sarsky/Mozzie/docs/source/PreFlight.rst

Pre-Flight
===========

== ================================================================================
   **Pre Flight Checklist**
== ================================================================================
1  Check wings and quad assemblies for damage and ensure they are secured
2  Check control linkages and surfaces for defects
3  Check wiring connections and cables for defects
4  Check motor spin/dir/mounts and that props are tight with wrench
5  RC TX booted, TX Bat ok, PXH Mode ok, throttle down?
6  Check Batteries and install, COG ok, PXH green, pitot clear?
7  Airspeed, avionics, AHRS/IMU, Compass, GPS 3d lock, Bat, all ok on MP, precal?
8  Check control surfaces in Stabilise, quad motors in Qstabilise
9  Critical Parameters ok? Mission WP ok and RTL loaded?
10 Arm in stabilise/qstabilise and launch.
== ================================================================================

================== ============ ============
**Battery State**  **4S Lipo**  **4S LiHV**
================== ============ ============
100%               16.8V
80%                15.6V
60%                15.4V
50%                15.28V
40%                15V
20%                14.8V
10%                14.7V
================== ============ ============

=================== ===================== ================== =========================
**PXH LED Codes**   **Fault**             **Cause**          **Remedy**
=================== ===================== ================== =========================
Green LED	          PXH Booted - GPS Lock Ready to ARM
Blue LED	          NO GPS Lock	          Bad GPS Health     GPS Satellite' Visible?
Flashing yellow LED Failsafe triggered    Restart PXH	     Check failsafe to trigger
=================== ===================== ================== =========================

============== ===================== ========================= ==========================
**GPS LED**    **Fault**             **Cause**                 **Remedy**
============== ===================== ========================= ==========================
GPS Power      No Red LED            No Power - No Connection  Check power and wiring
GPS Signal     No Flashing Blue LED  No Lock - NO GPS Signal   GPS Satellites Visible?
============== ===================== ========================= ==========================

Flight Modes
-------------

List flight modes to be used with Mozzie

Range Check
----------------

RX range Check - chk RX setup and link - is this relevant with PPM over RFDx??

RFD900x Range Check?
