sarsky/Mozzie/docs/source/images/AE/3DPrintAs.png

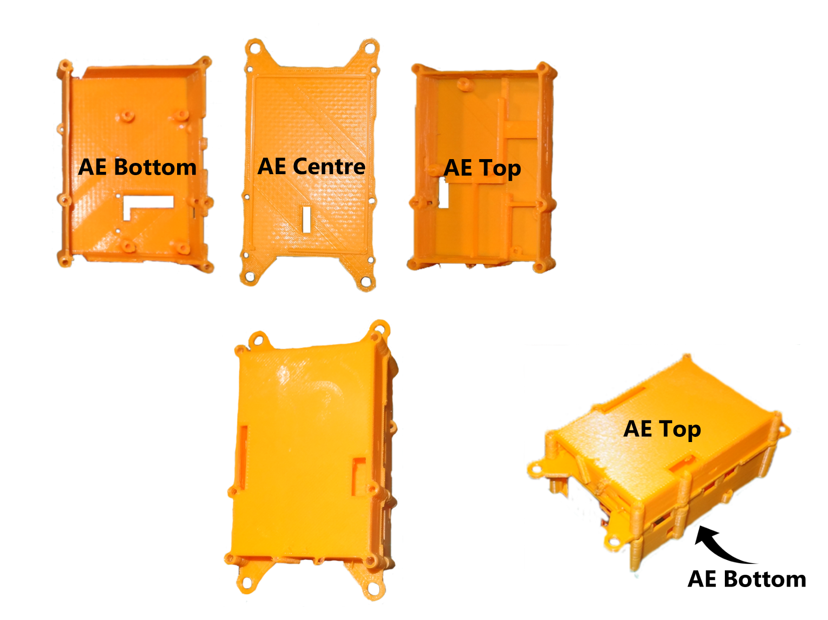
docs/source/images/AE/3DPrintAs.png
