sarsky/Mozzie/docs/source/images/AE/AEPixhawk.jpg

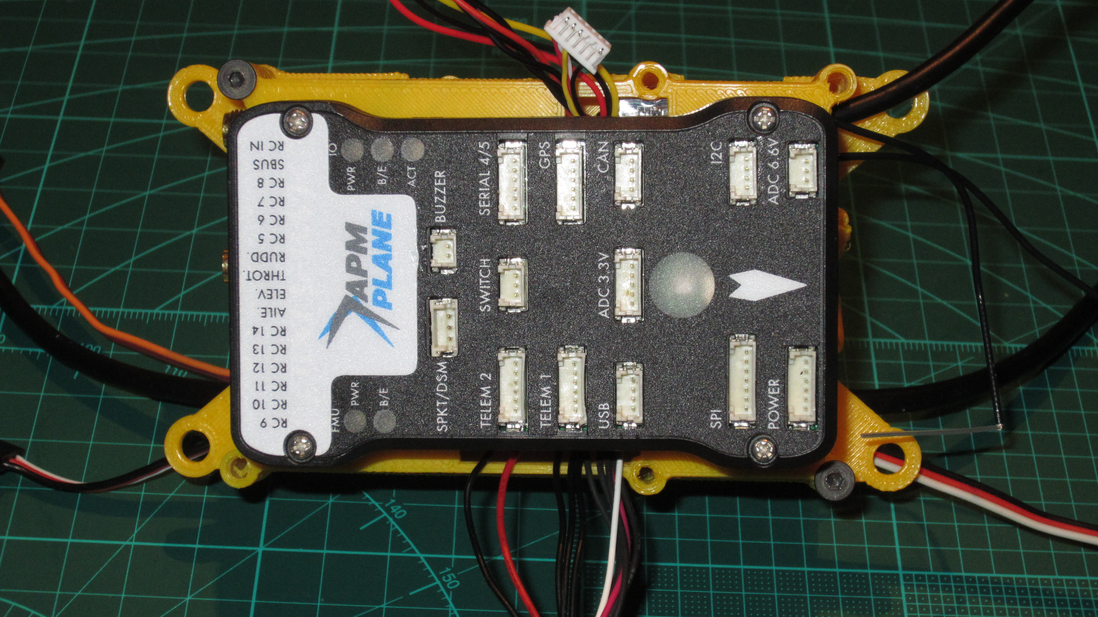
docs/source/images/AE/AEPixhawk.jpg
