sarsky/Mozzie/docs/source/images/AE/AEPixhawkCables2.jpg

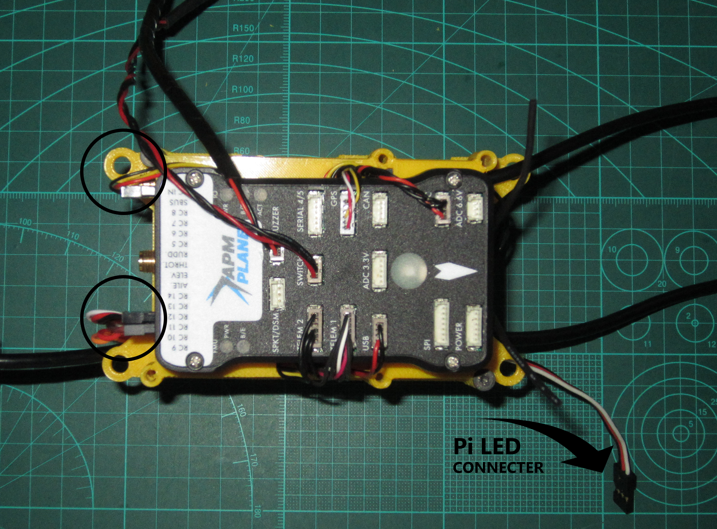
docs/source/images/AE/AEPixhawkCables2.jpg
