sarsky/Mozzie/docs/source/images/AE/AEPixhawkCables.jpg

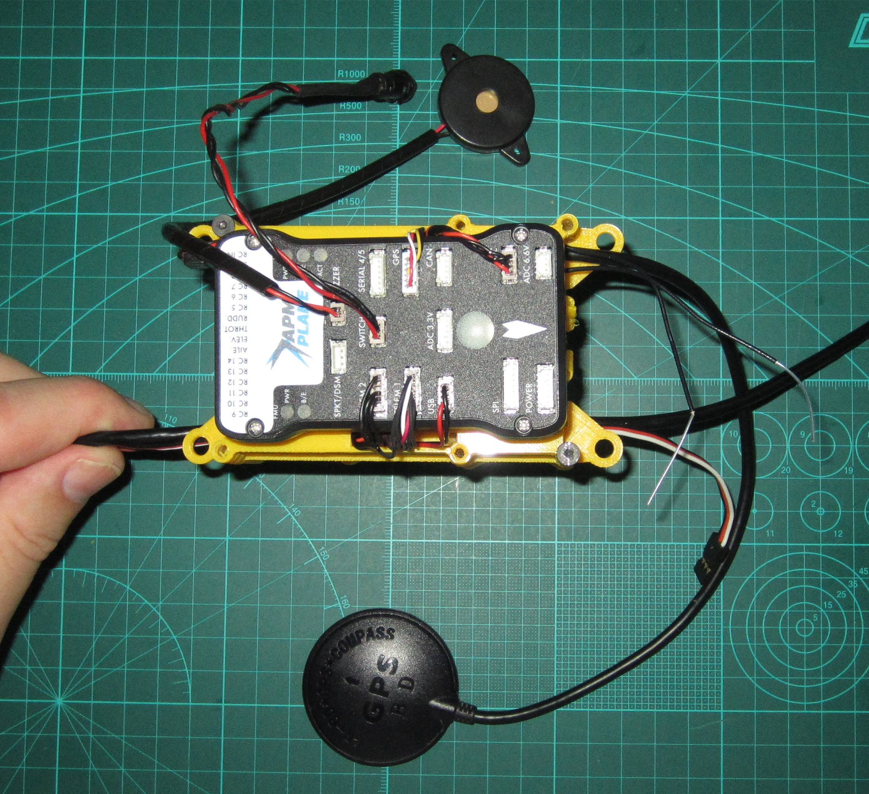
docs/source/images/AE/AEPixhawkCables.jpg
