sarsky/Mozzie/docs/source/images/AE/AirAECompGPS.jpg

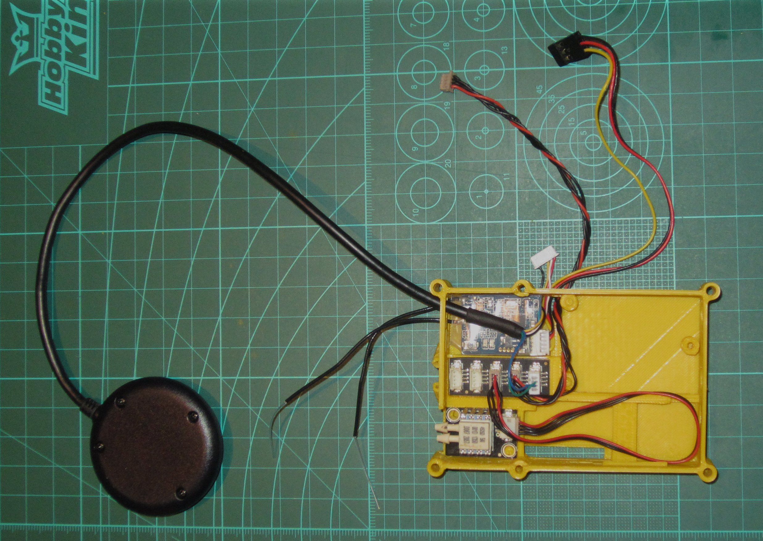
docs/source/images/AE/AirAECompGPS.jpg
