sarsky/Mozzie/docs/source/images/AE/AirAECompRFD.jpg

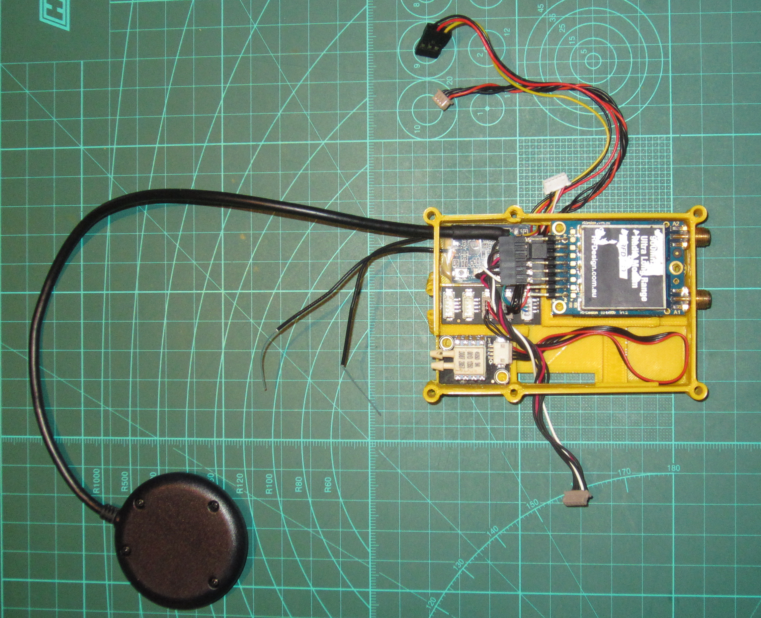
docs/source/images/AE/AirAECompRFD.jpg
