sarsky/Mozzie/docs/source/images/AE/FuseCut.jpg

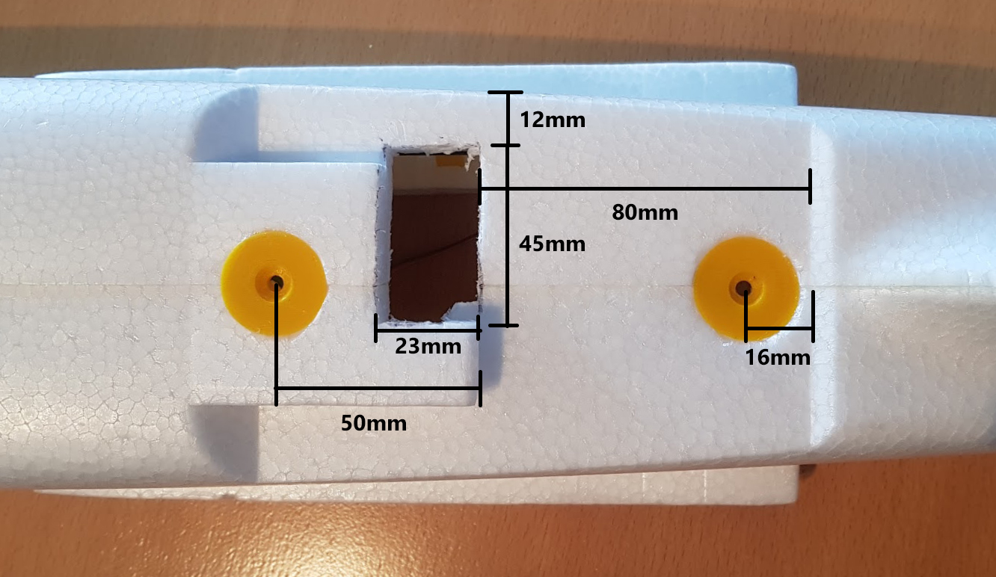
docs/source/images/AE/FuseCut.jpg
