sarsky/Mozzie/docs/source/images/AE/MountBallsCenter.jpg

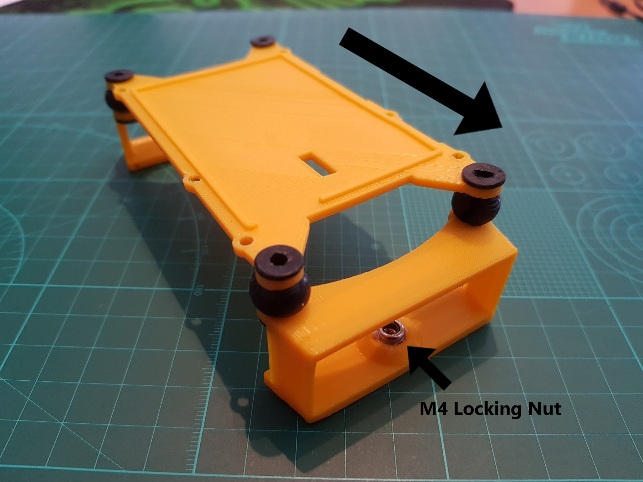
docs/source/images/AE/MountBallsCenter.jpg
