sarsky/Mozzie/docs/source/images/AE/PiAEToAirAE.jpg

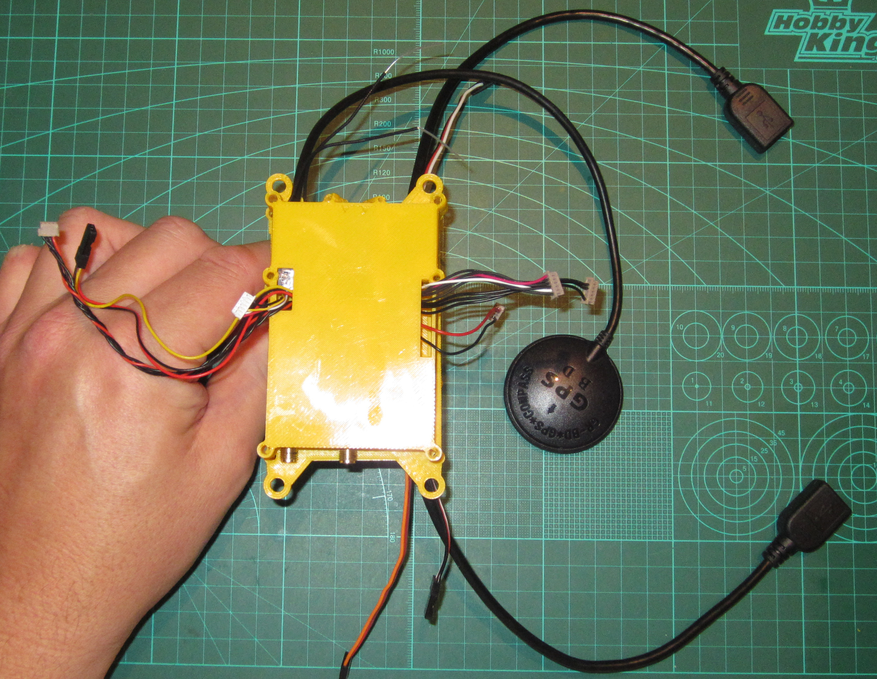
docs/source/images/AE/PiAEToAirAE.jpg
