sarsky/Mozzie/docs/source/images/AE/PiAEToCenter.jpg

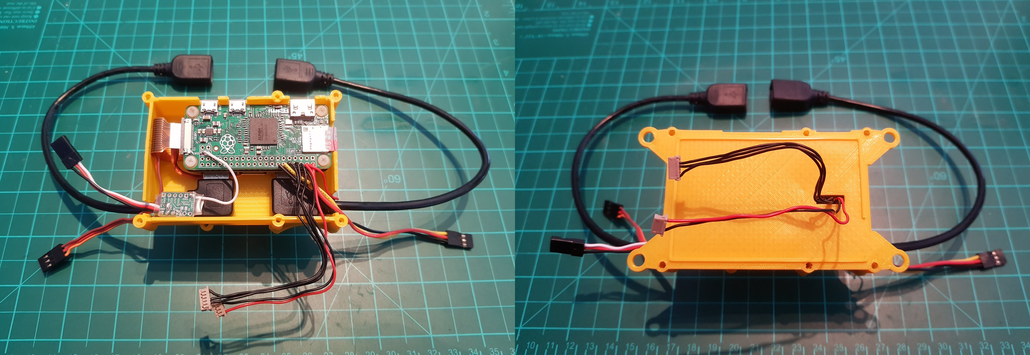
docs/source/images/AE/PiAEToCenter.jpg
