sarsky/Mozzie/docs/source/images/AE/PiNHub.jpg

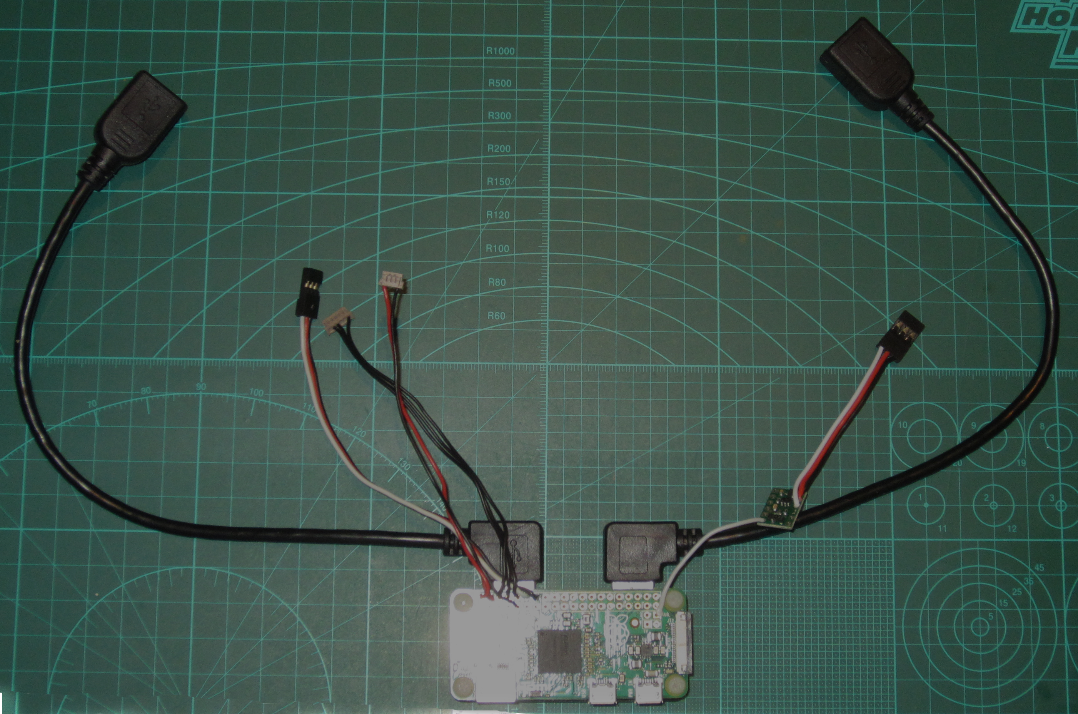
docs/source/images/AE/PiNHub.jpg
