sarsky/Mozzie/docs/source/images/AE/RFD900x/RFD900x_FTDI.jpg

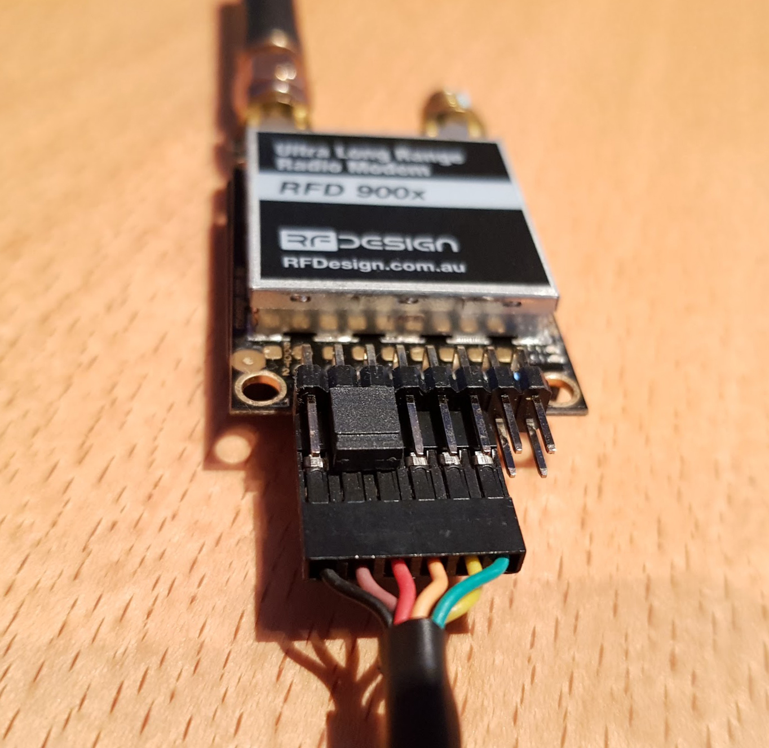
docs/source/images/AE/RFD900x/RFD900x_FTDI.jpg
