sarsky/Mozzie/docs/source/images/AE/RFD900x/RFD900x_Pins_SM.jpg

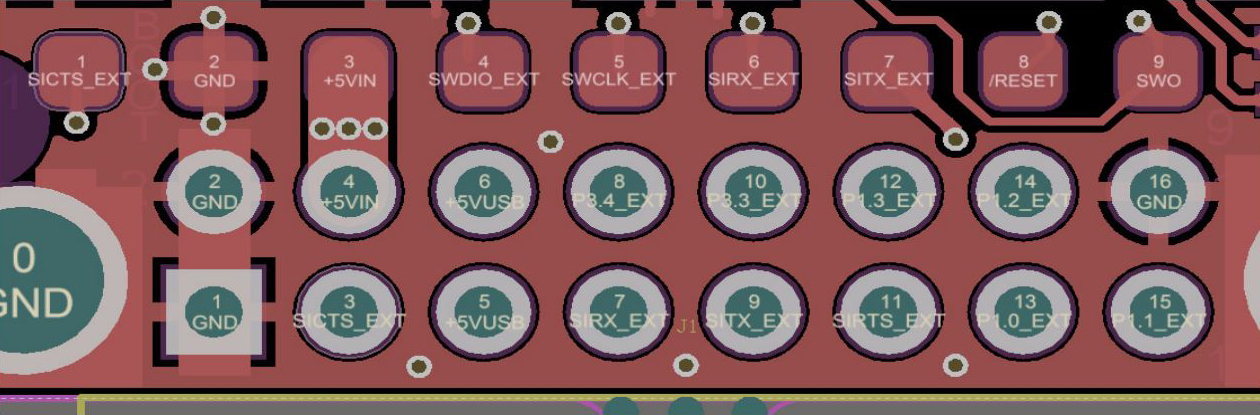
docs/source/images/AE/RFD900x/RFD900x_Pins_SM.jpg
