sarsky/Mozzie/docs/source/images/AE/ServoMountAs.jpg

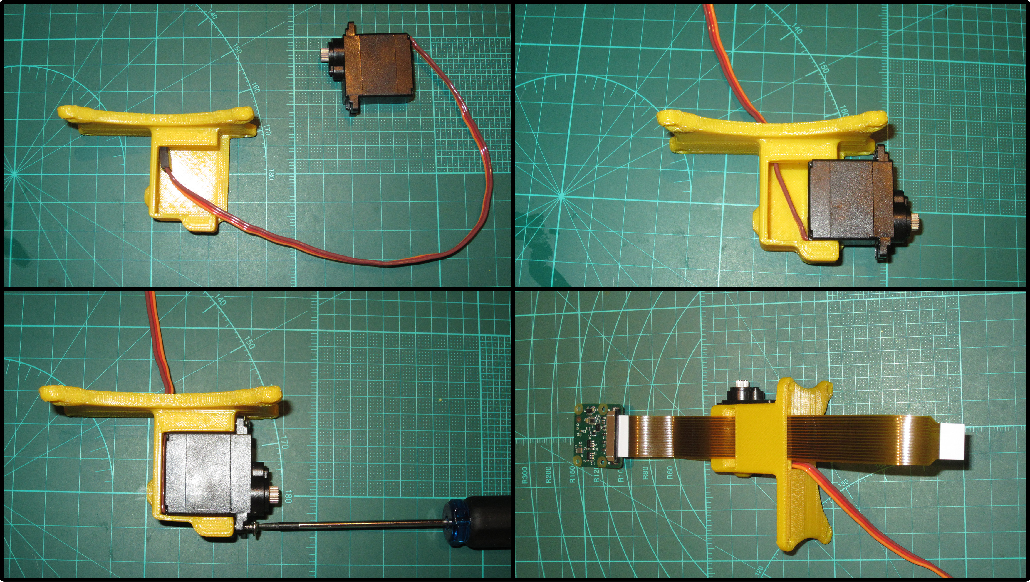
docs/source/images/AE/ServoMountAs.jpg
