sarsky/Mozzie/docs/source/images/AE/ServoMountCam.jpg

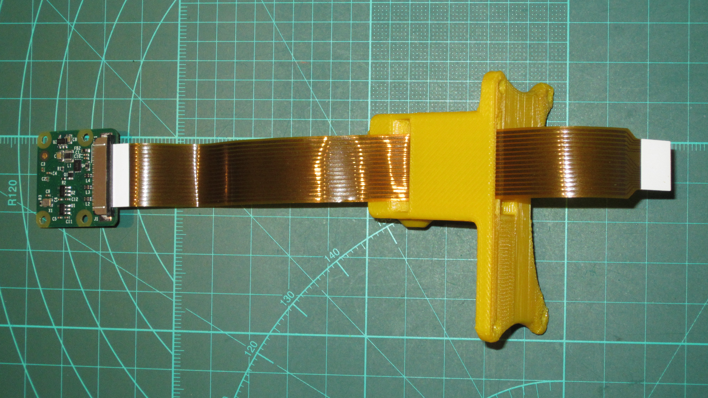
docs/source/images/AE/ServoMountCam.jpg
