sarsky/Mozzie/docs/source/images/AE/ServoToPiAE.jpg

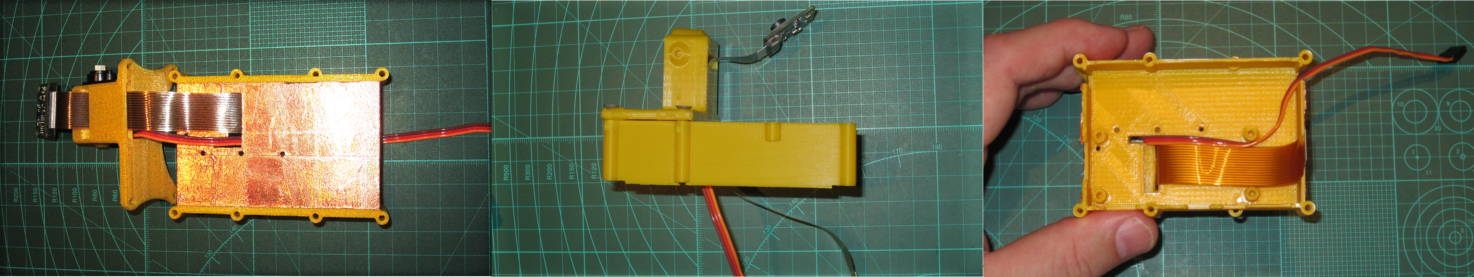
docs/source/images/AE/ServoToPiAE.jpg
