sarsky/Mozzie/docs/source/images/Fuselage/Skids.jpg

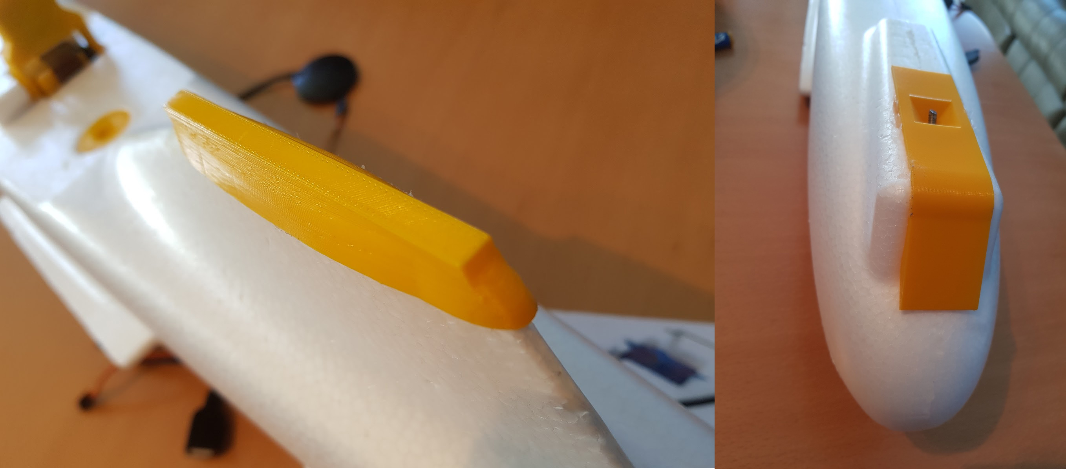
docs/source/images/Fuselage/Skids.jpg
