sarsky/Mozzie/docs/source/images/Fuselage/TalonFuselageGlue.JPG

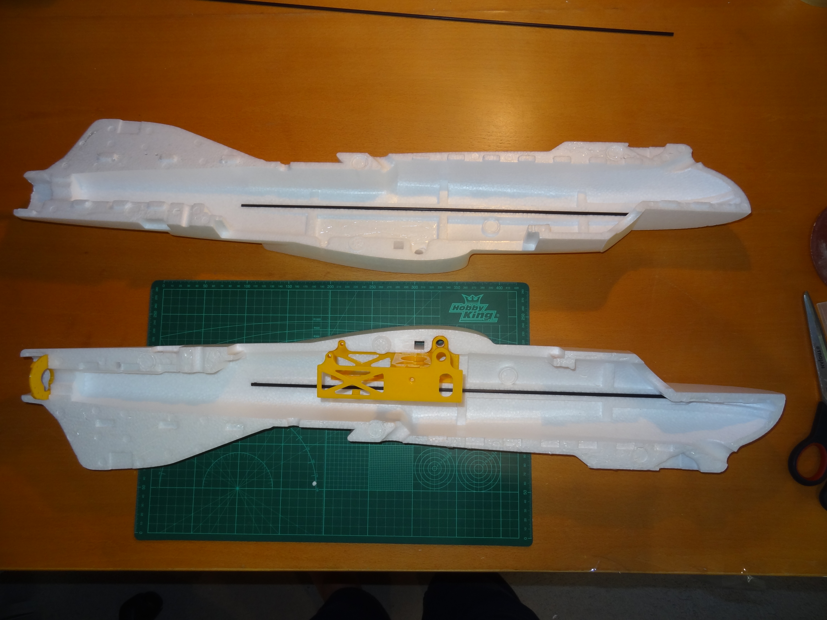
docs/source/images/Fuselage/TalonFuselageGlue.JPG
