sarsky/Mozzie/docs/source/images/mozziecompleted.jpg

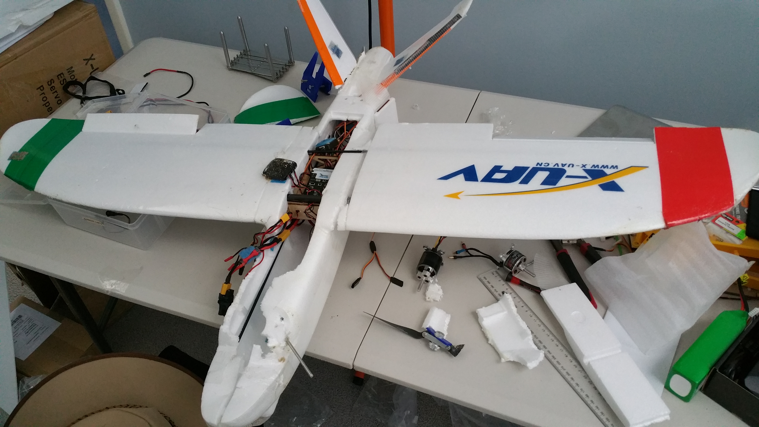
docs/source/images/mozziecompleted.jpg
