sarsky/Mozzie/docs/source/images/Propulsion/BLHeli_ArduinoESC_SM.jpg

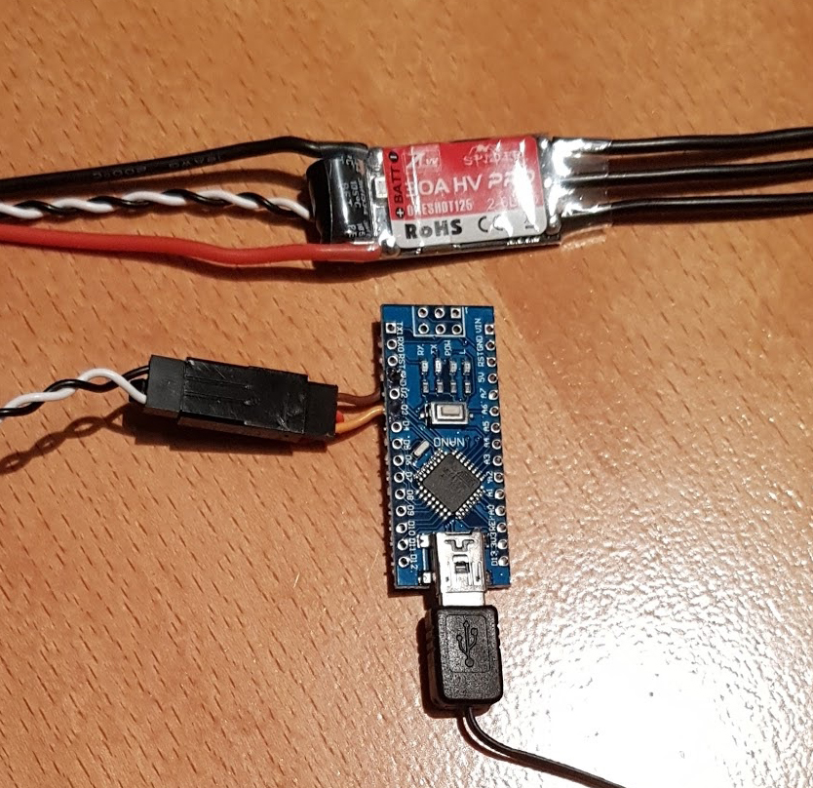
docs/source/images/Propulsion/BLHeli_ArduinoESC_SM.jpg
