sarsky/Mozzie/docs/source/images/Wings/WingPen1.jpg

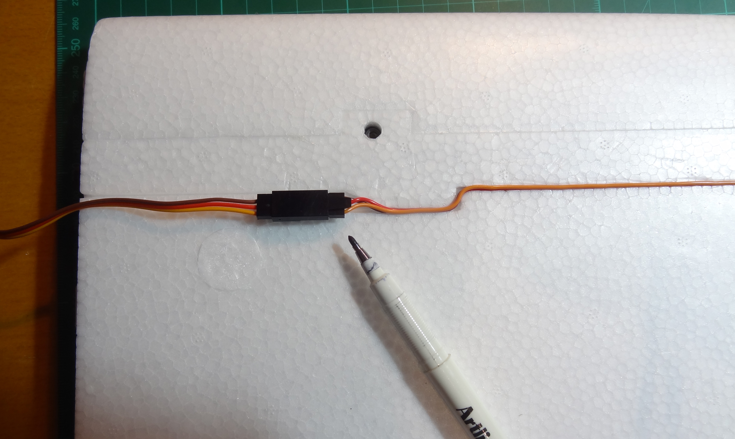
docs/source/images/Wings/WingPen1.jpg
