sarsky/Mozzie/docs/source/images/Wings/WingServoCable_SM.jpg

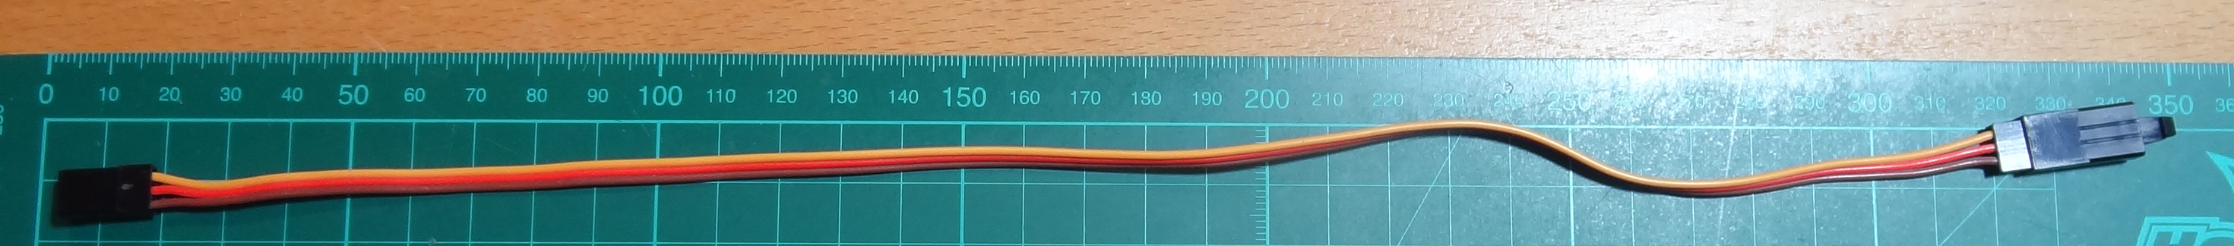
docs/source/images/Wings/WingServoCable_SM.jpg
