sarsky/Mozzie/docs/source/images/Wings/WingServoMark.jpg

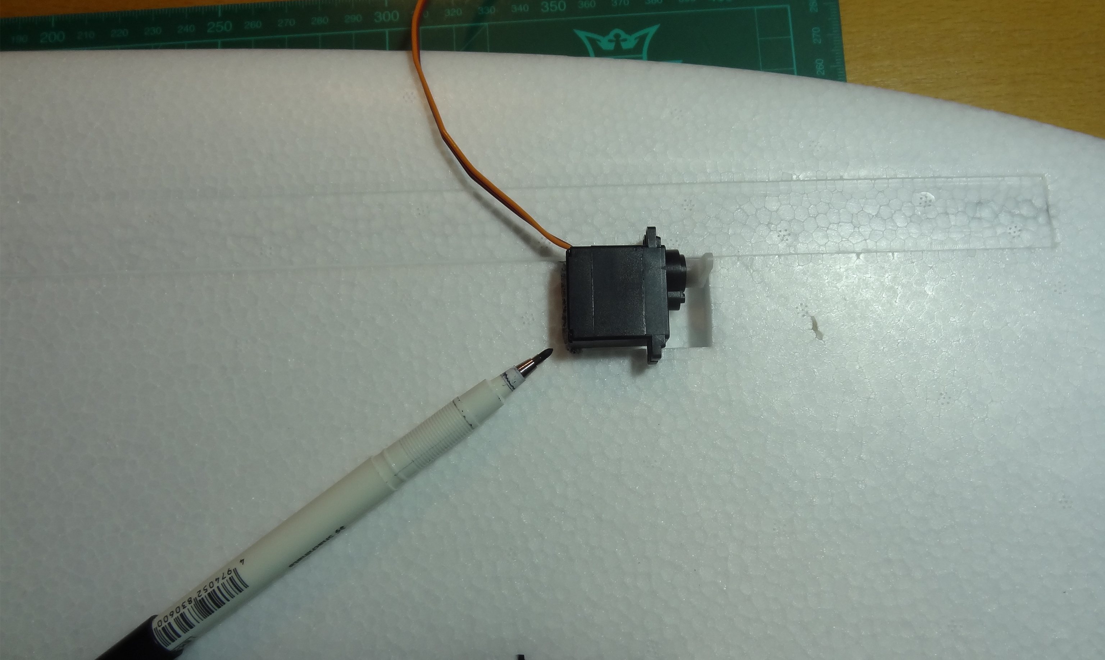
docs/source/images/Wings/WingServoMark.jpg
