sarsky/Mozzie/3d/Airframe/Gps Mount M8.stl

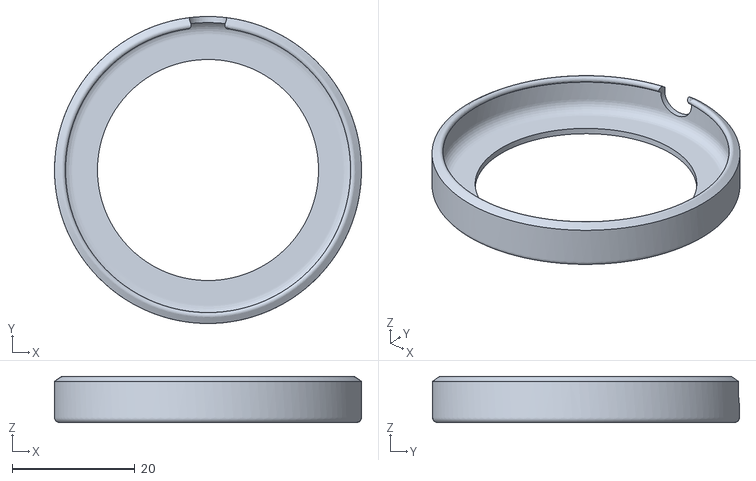
[picture p54: CAD file, 2017-07-15]
3d/Airframe/Gps Mount M8.stl
50.0 x 50.0 x 7.51
