sarsky/Mozzie/3d/QuadArm/CF Motor Mount Right Aero v4.stl

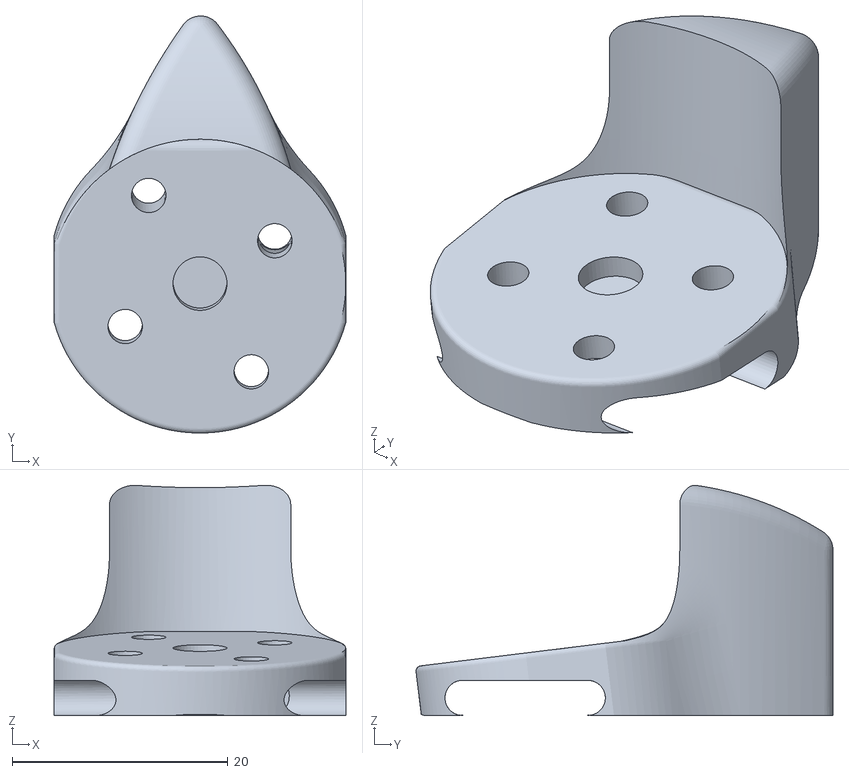
[picture p55: CAD file, 2017-06-14]
3d/QuadArm/CF Motor Mount Right Aero v4.stl
27.0 x 38.6 x 21.3
