sarsky/Mozzie/3d/Airframe/Short GPS Cable Conduit 36mm.stl

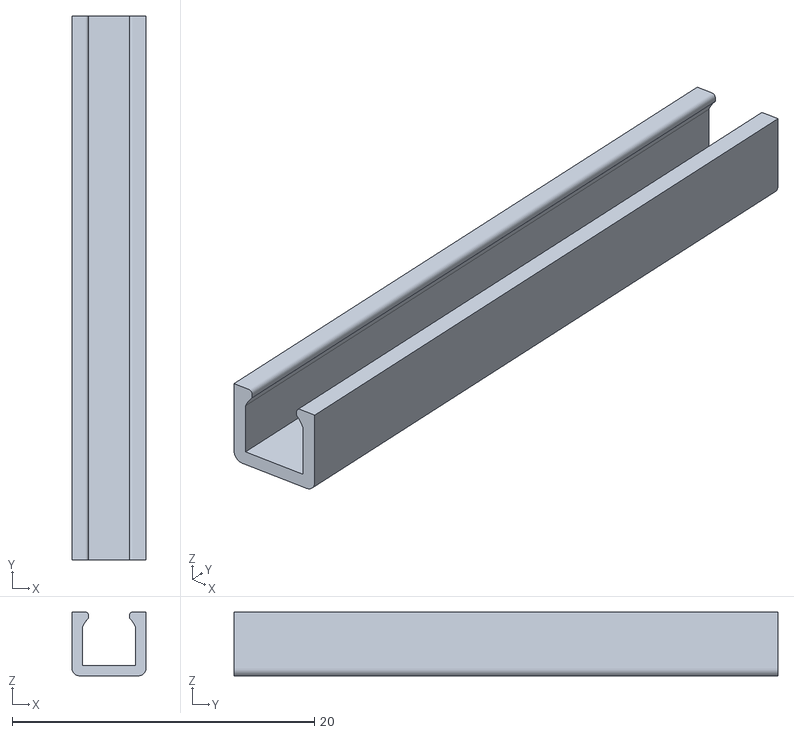
[picture p56: CAD file, 2017-07-15]
3d/Airframe/Short GPS Cable Conduit 36mm.stl
4.90 x 36.0 x 4.22
