sarsky/Mozzie/3d/Avionics/Pitot Tube base.stl

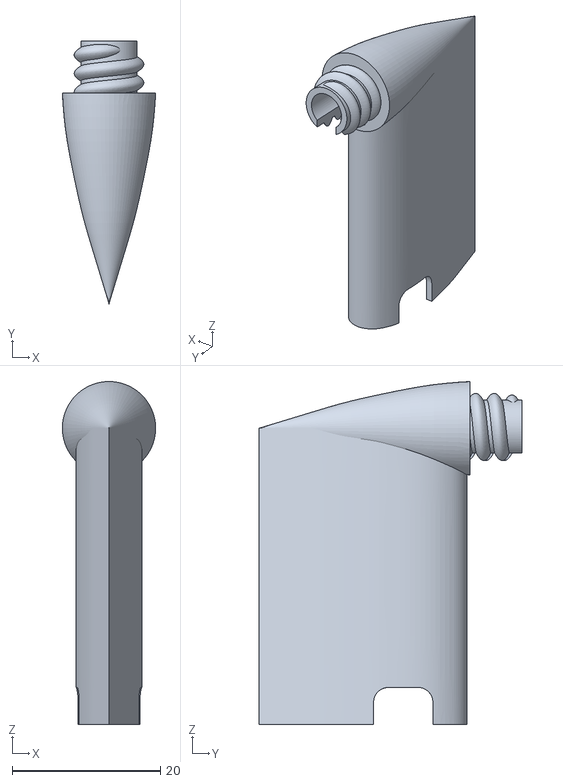
[picture p57: CAD file, 2017-07-15]
3d/Avionics/Pitot Tube base.stl
12.6 x 35.4 x 46.3
