sarsky/Mozzie/3d/QuadArm/CF Mid Mount L.stl

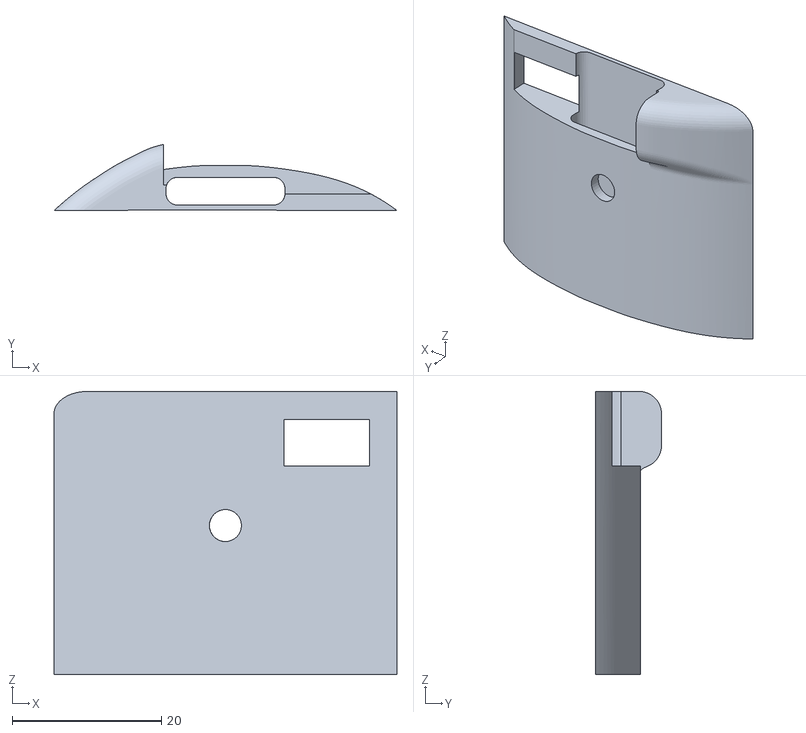
[picture p58: CAD file, 2017-06-14]
3d/QuadArm/CF Mid Mount L.stl
46.0 x 8.86 x 38.0
