sarsky/Mozzie/3d/Airframe/ESC Scoop.stl

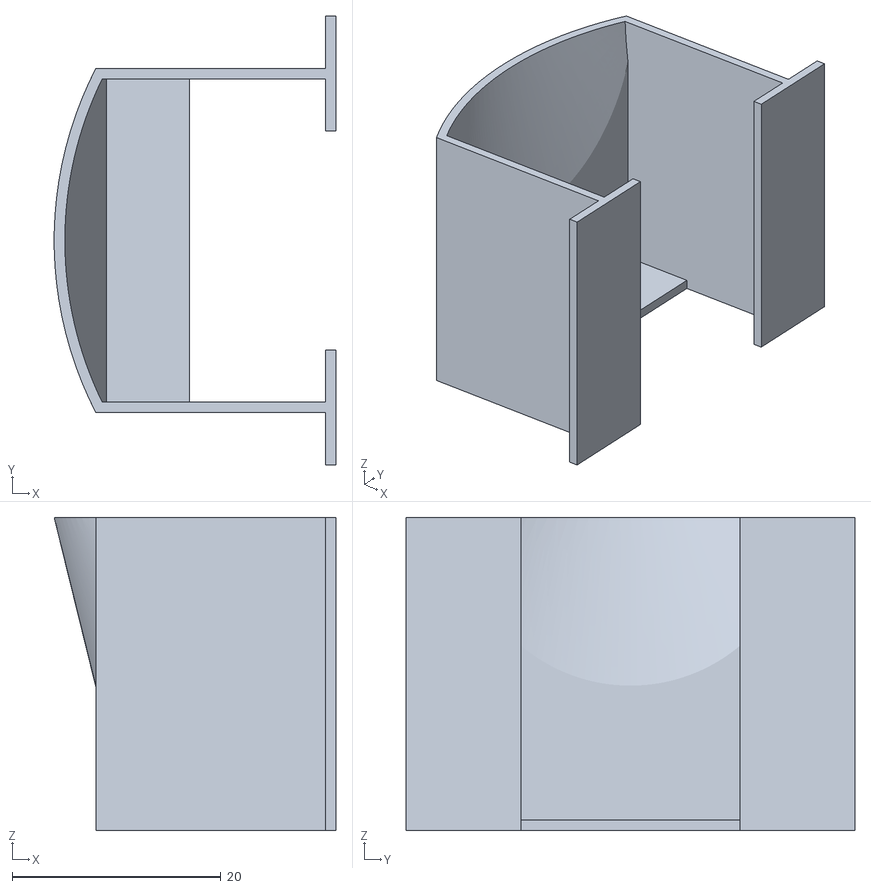
[picture p59: CAD file, 2017-06-14]
3d/Airframe/ESC Scoop.stl
27.0 x 43.0 x 30.0
