sarsky/Mozzie/3d/Avionics/Pitot Tube Front 4-1mm.stl

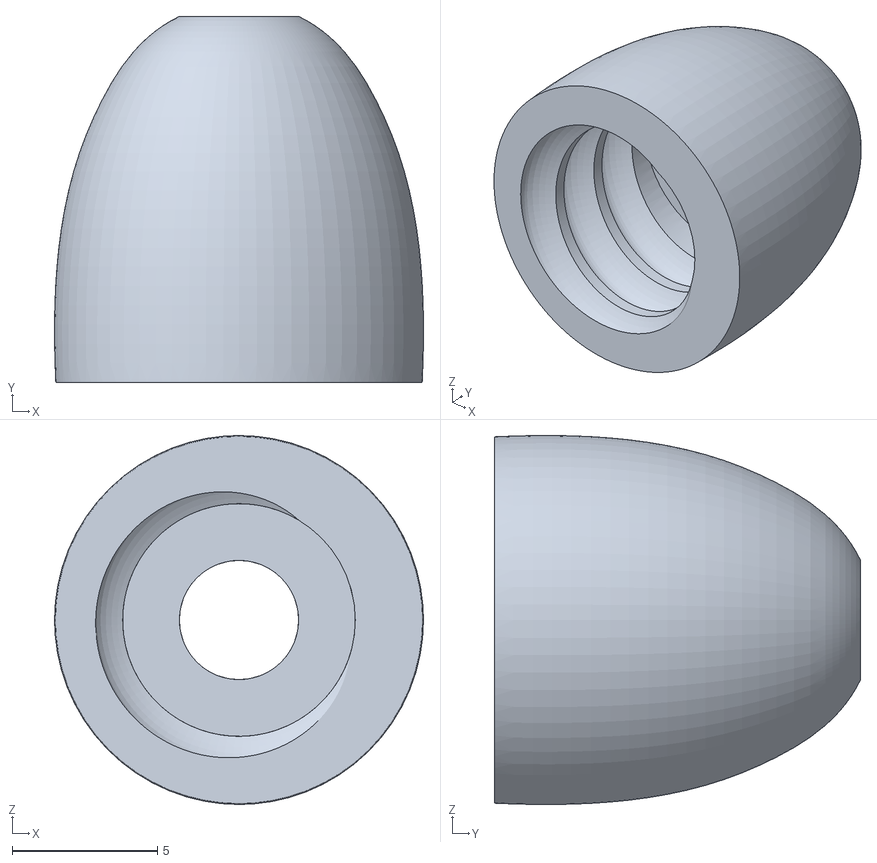
[picture p60: CAD file, 2017-07-15]
3d/Avionics/Pitot Tube Front 4-1mm.stl
12.7 x 12.6 x 12.7
