sarsky/Mozzie/3d/Airframe/Long GPS Cable Conduit 80mm.stl

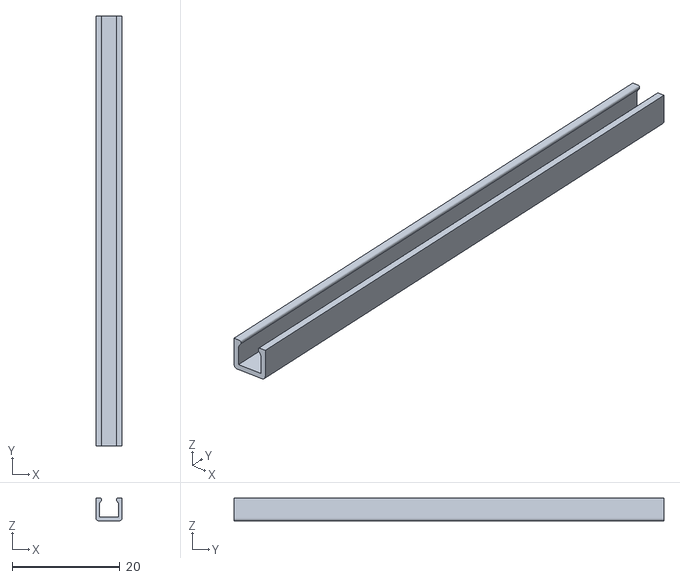
[picture p61: CAD file, 2017-06-14]
3d/Airframe/Long GPS Cable Conduit 80mm.stl
4.90 x 80.0 x 4.22
