sarsky/Mozzie/3d/Avionics/AE Top Box.stl

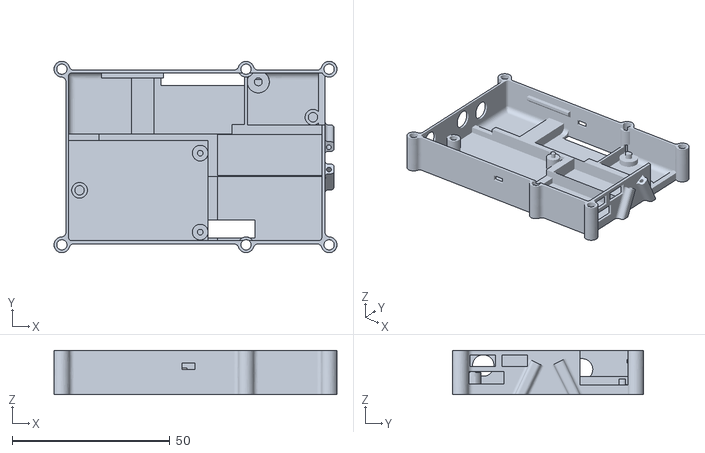
[picture p62: CAD file, 2017-06-14]
3d/Avionics/AE Top Box.stl
89.6 x 60.6 x 14.0
