sarsky/Mozzie/3d/QuadArm/Undermount back V7.stl

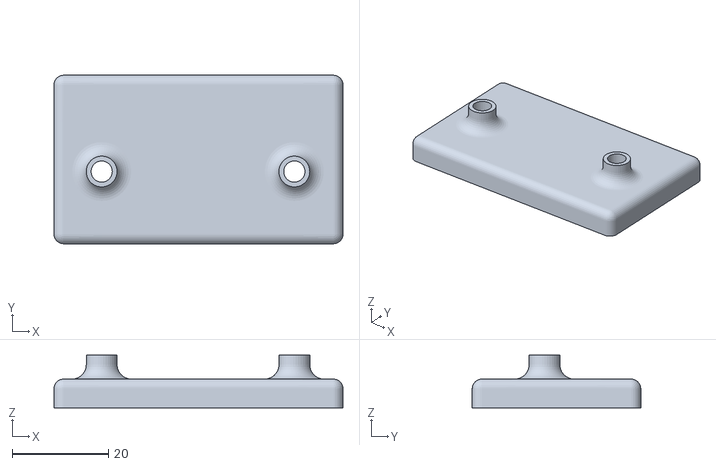
[picture p63: CAD file, 2017-05-27]
3d/QuadArm/Undermount back V7.stl
60.0 x 35.0 x 11.0
