sarsky/Mozzie/3d/Airframe/Tail skid.stl

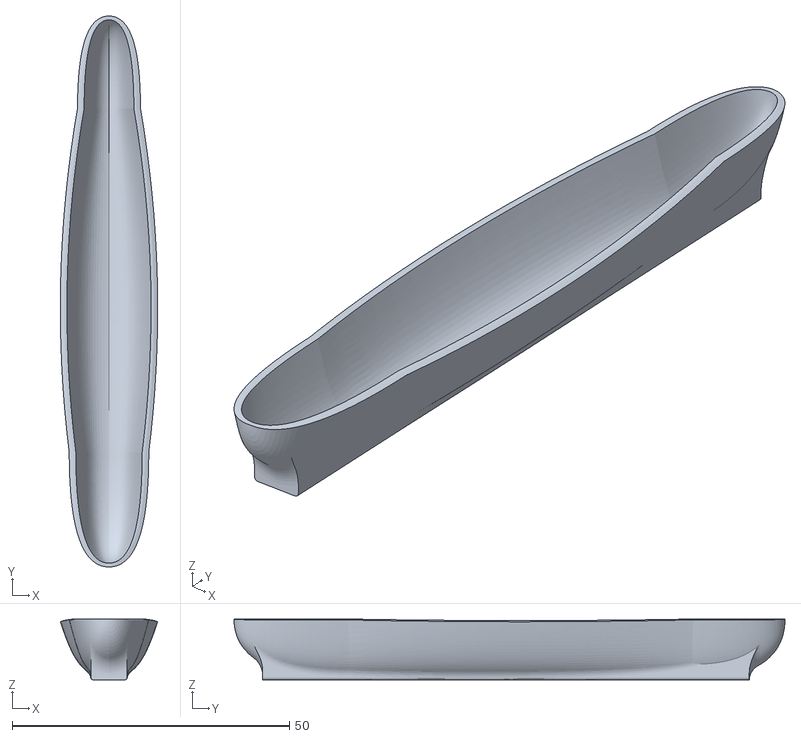
[picture p64: CAD file, 2017-06-14]
3d/Airframe/Tail skid.stl
17.6 x 99.4 x 11.0
