sarsky/Mozzie/3d/Avionics/AE Pi.stl

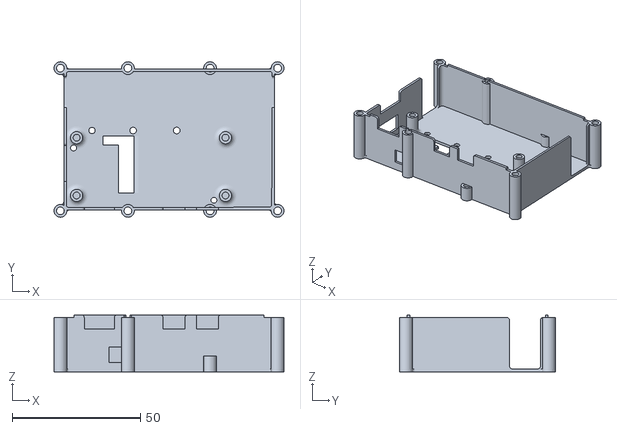
[picture p65: CAD file, 2017-06-14]
3d/Avionics/AE Pi.stl
89.6 x 60.6 x 22.2
