sarsky/Mozzie/3d/QuadArm/CF Mid Mount R.stl

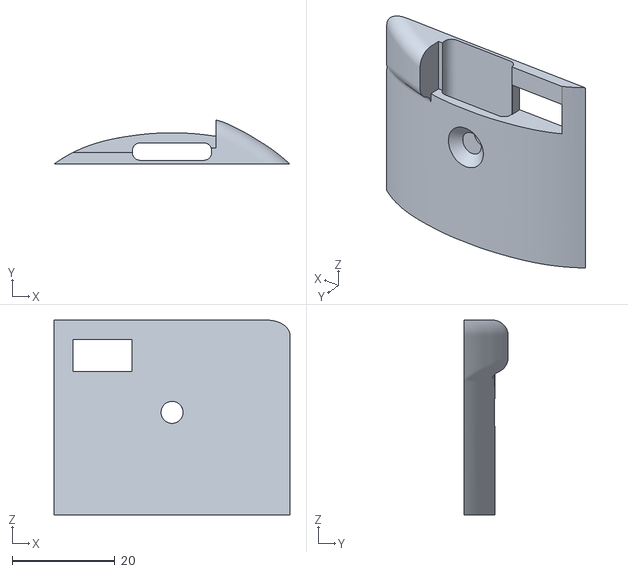
[picture p66: CAD file, 2017-05-27]
3d/QuadArm/CF Mid Mount R.stl
46.0 x 8.62 x 38.0
