sarsky/Mozzie/3d/Airframe/Talon Box Wall L (Vial near CF).stl

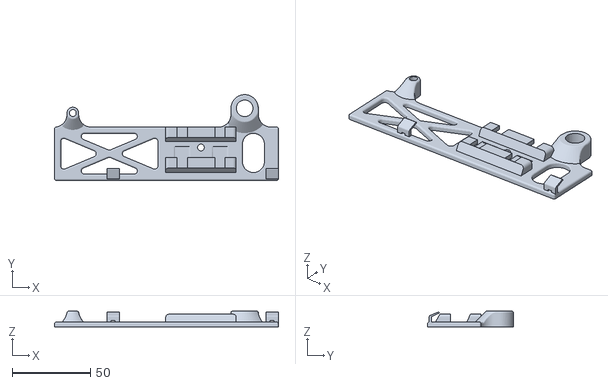
[picture p67: CAD file, 2017-06-14]
3d/Airframe/Talon Box Wall L (Vial near CF).stl
143.0 x 54.8 x 10.0
