sarsky/Mozzie/3d/Avionics/AE Camera Servo Mount.stl

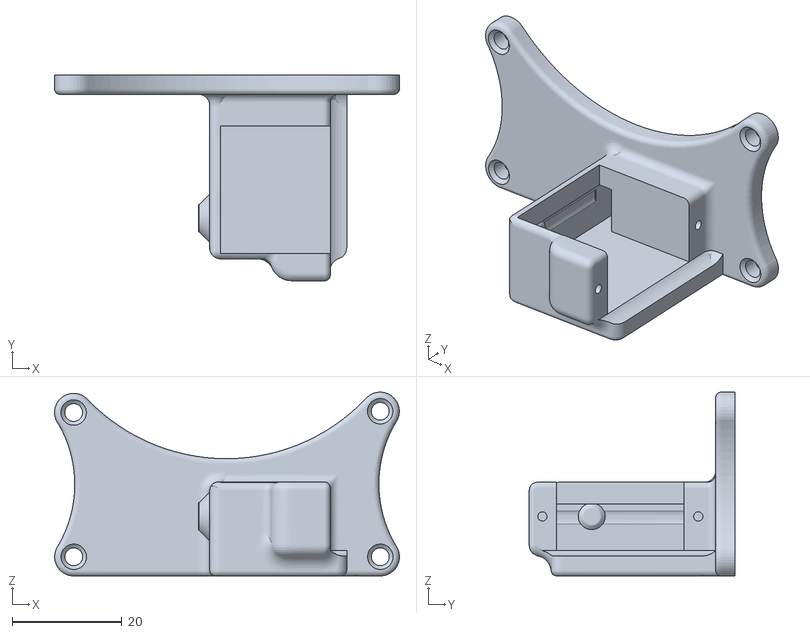
[picture p68: CAD file, 2017-06-14]
3d/Avionics/AE Camera Servo Mount.stl
62.9 x 37.5 x 33.5
