sarsky/Mozzie/3d/Airframe/Talon Box Cross Section.stl

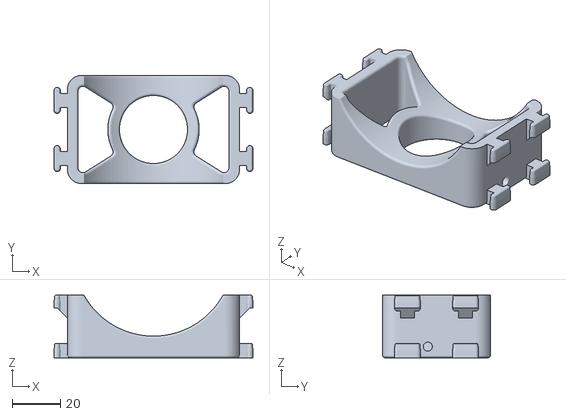
[picture p69: CAD file, 2017-06-14]
3d/Airframe/Talon Box Cross Section.stl
82.8 x 45.0 x 26.0
