sarsky/Mozzie/3d/Airframe/Mount Motor v1.stl

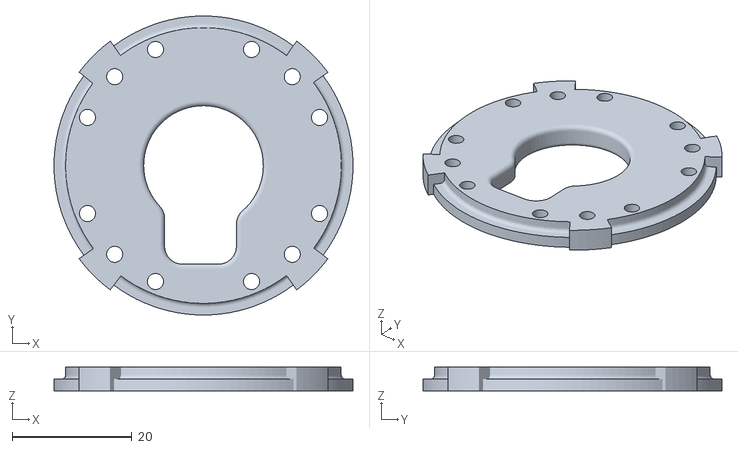
[picture p70: CAD file, 2017-05-27]
3d/Airframe/Mount Motor v1.stl
50.0 x 50.0 x 4.00
