sarsky/Mozzie/3d/Avionics/AE Plate.stl

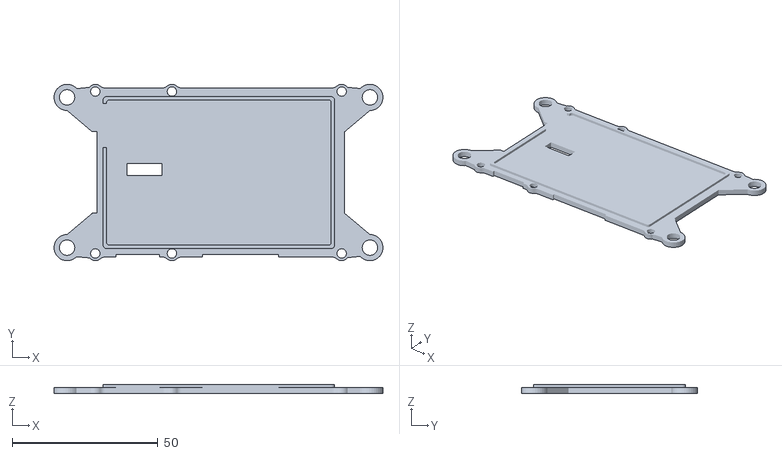
[picture p71: CAD file, 2017-06-14]
3d/Avionics/AE Plate.stl
113.0 x 60.6 x 3.20
