sarsky/Mozzie/3d/Avionics/AE Camera Case.stl

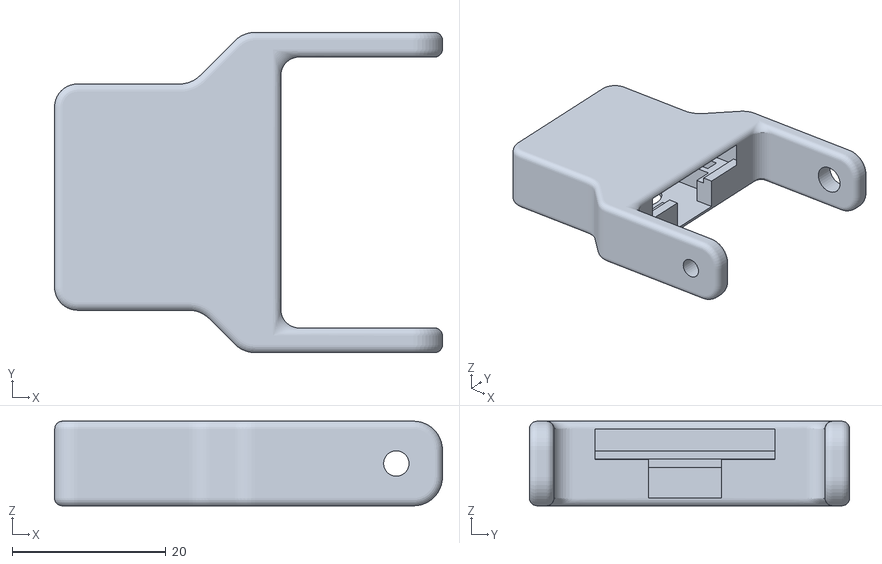
[picture p72: CAD file, 2017-06-14]
3d/Avionics/AE Camera Case.stl
50.4 x 41.6 x 11.0
