sarsky/Mozzie/3d/Airframe/Front Skid.stl

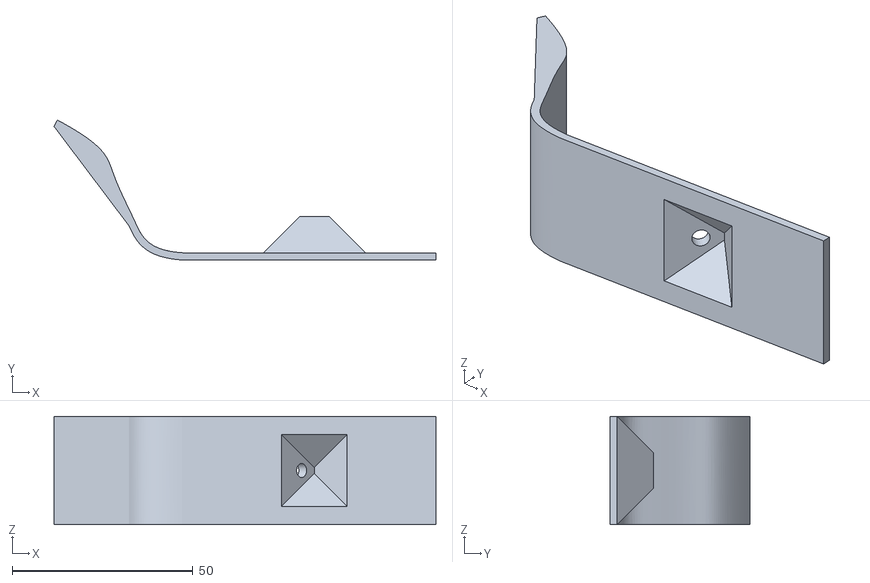
[picture p73: CAD file, 2017-05-27]
3d/Airframe/Front Skid.stl
105.7 x 38.7 x 30.0
