sarsky/Mozzie/3d/Avionics/Arm Switch.stl

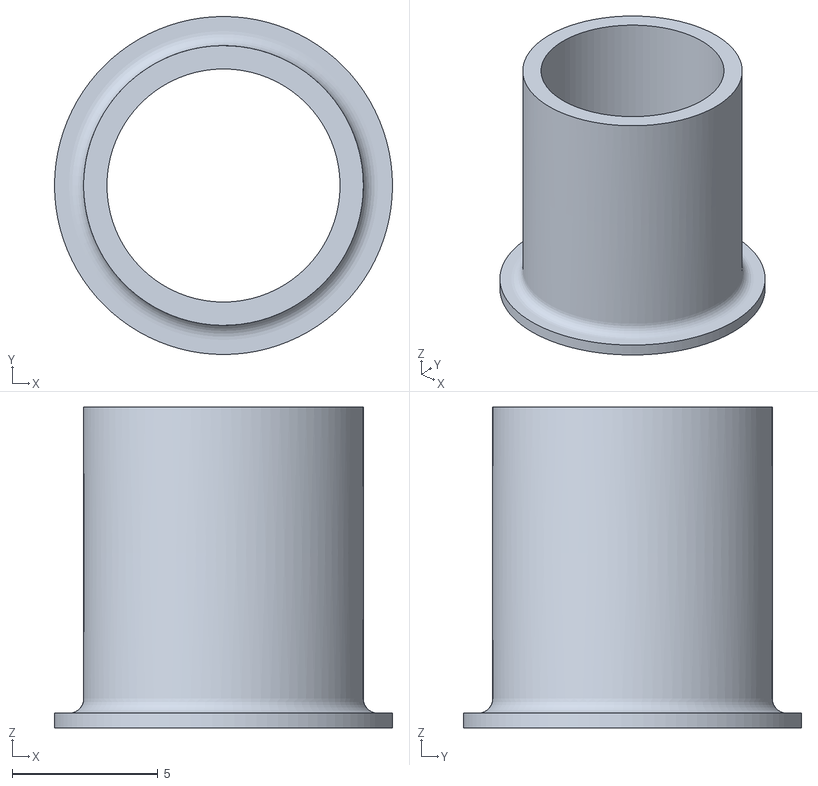
[picture p74: CAD file, 2017-06-14]
3d/Avionics/Arm Switch.stl
11.6 x 11.6 x 11.0
