sarsky/Mozzie/3d/Airframe/E-Stop.stl

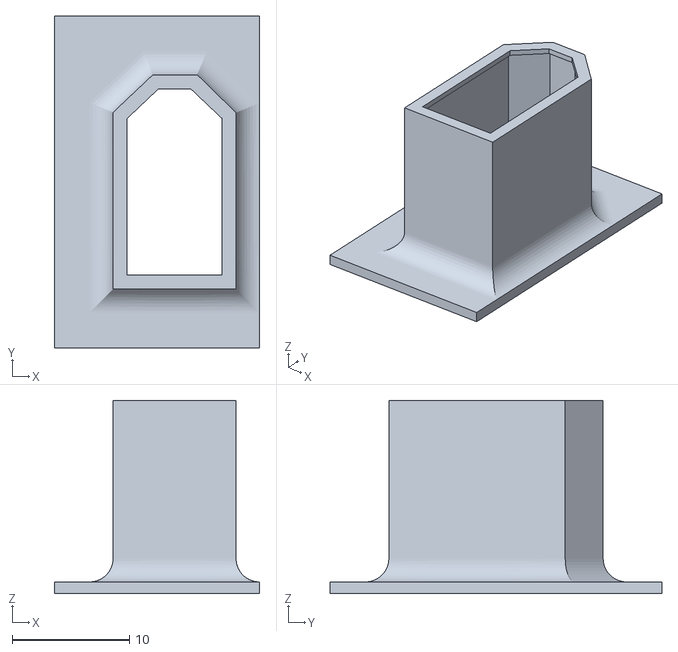
[picture p75: CAD file, 2017-05-27]
3d/Airframe/E-Stop.stl
17.5 x 28.3 x 16.5
