sarsky/Mozzie/3d/Avionics/AE Front Mount.stl

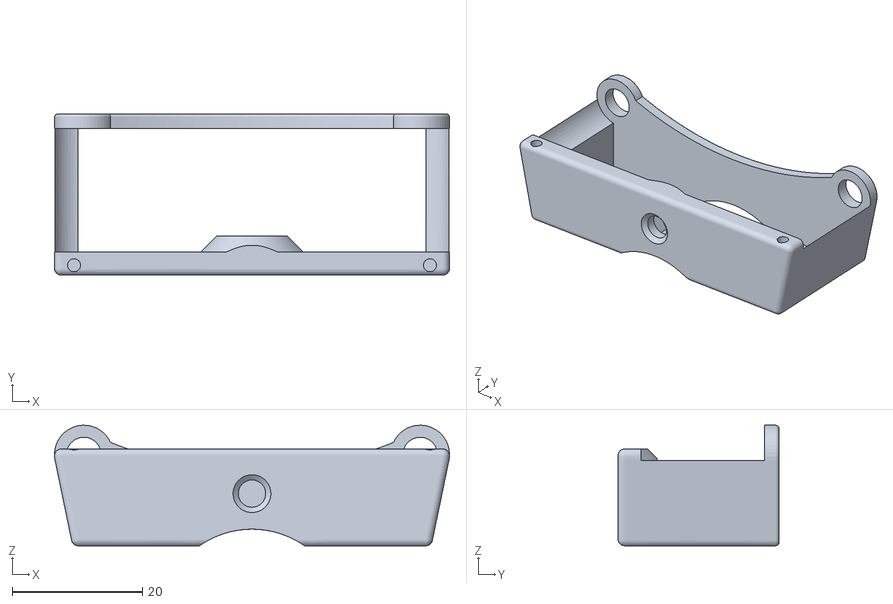
[picture p76: CAD file, 2017-05-27]
3d/Avionics/AE Front Mount.stl
60.6 x 24.7 x 18.5
