sarsky/Mozzie/3d/Avionics/AE Rear Mount.stl

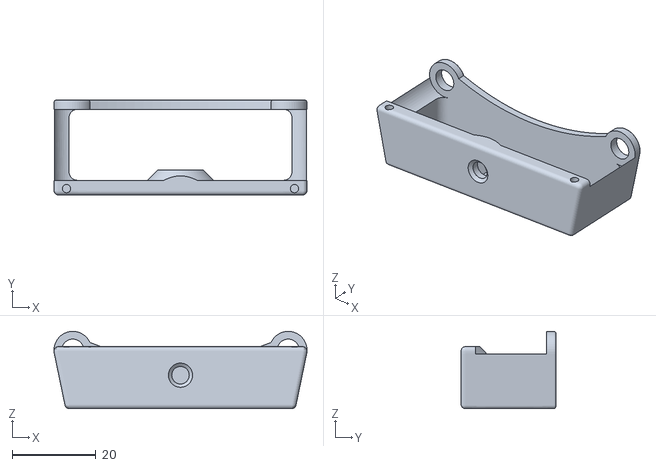
[picture p77: CAD file, 2017-05-27]
3d/Avionics/AE Rear Mount.stl
60.6 x 22.7 x 18.5
