sarsky/Mozzie/3d/Avionics/3G Modem.stl

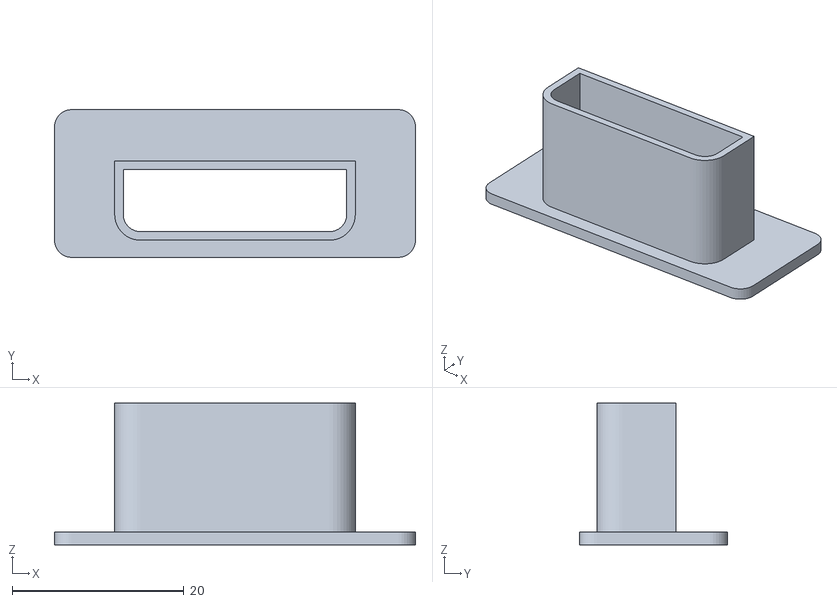
[picture p78: CAD file, 2017-05-27]
3d/Avionics/3G Modem.stl
42.0 x 17.2 x 16.5
