sarsky/Mozzie/(list of files, cad)

Other CAD files:
3d/QuadArm/CF Motor Mount LEFT Aero v4.stl
3d/Airframe/Talon Box Wall R (Vial near CF).stl
3d/Avionics/Ball Mount Screw Washer Large.stl
3d/Avionics/Ball Mount Screw Washer Small.stl
