sarsky/Mozzie/docs/source/GettingStarted.rst

Getting Started
================

Complete Parts List
-----------------------

The first step to building the Mozzie is to organize and purchase all the parts.

.. Tip::
  The selected components listed here have undergone a series of tests for performance and reliability,
  however we can not guarantee their individual performance as we do not manufacture or assemble them.

Purchase List
^^^^^^^^^^^^^^^^

.. note::
  If you would like to support the Mozzie development, and if it is cost effective, please use the affiliate product links provided for Banggood to purchase those components, as that will help support the further development of the Mozzie platform at no extra cost to you.
  If you wish to support us with any other purchase you make through our affiliate store you can use this `Banggood <https://www.banggood.com/?p=U4150312300081201707>`_ link
  or alternatively if you don't won't to use the affiliate links feel free to remove 20 digit number on the end of the BG links.

.. Tip::
  From time to time the freight options change in these stores so it is advisable to look for local stock to reduce freight costs, in particular on the larger items like the airframe or batteries.

   * Talon ships from BG in single units via EMS. (currently it's expensive - so maybe try it locally)
   * Batteries have limited shipping methods due to safety so try to shop locally for these if you can.

====================  =================================== ========== ======== ======================================
**System**            **Item**                            **Weight**  **PCS** **Link**
====================  =================================== ========== ======== ======================================
**Airframe**          Mini Talon                           562g          1     `Banggood <https://www.banggood.com/X-uav-Mini-Talon-EPO-1300mm-Wingspan-V-tail-FPV-Plane-Aircraft-Kit-p-983331.html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>`__
|                     Carbon Bar for QP Arms (1m)           27g ea.      1     `Carbon Fibre Aus <http://www.carbonfiber.com.au/prod80.htm>`__
|                     M4 Screws                                          6      1x20mm, 1x28mm, 2x 25mm, 2x 40mm
**Propulsion**        QP Motor Cobra 2207 2300              31g ea.      4     `Banggood <https://www.banggood.com/Cobra-Champion-Series-2207-CP2207-2300KV-2450KV3-5S-Brushless-Motor-For-250-260-280-FPV-Racing-Frame-p-1108143.html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>`__
|                     QP ESC ZTW Spider Pro HV 30A F390      6g          4     `Bolt RC <https://boltrc.com.au/index.php?id_product=127&controller=product>`__
|                     Fwd Motor Cobra C-2814/16 Kv 1050     107g         1     `Innov8tive <http://innov8tivedesigns.com/parts/brushless-motors/cobra-c-2814-16-brushless-motor-kv-1050>`__
|                     40A ESC (with Brake)                   50g         1
|                     Prop Aeronaut 10x8                                 1     `PerthRC <http://www.perthrc.com.au/folding-prop-10x8.html>`__
|                     Spinner Bar Aeronaut                               1     `PerthRC <http://www.perthrc.com.au/spinner-bar-42mm-0-degrees.html>`__
|                     HQProp GlassNylon 6x3.5 2xCW+2xCCW                 4     `Rotorgeeks <http://rotorgeeks.com/index.php?route=product/product&manufacturer_id=11&product_id=325>`_
**Electronics**       Battery MultiStar LiHV 4S 10Ah        794g         1     `HobbyKing <https://hobbyking.com/en_us/multistar-lihv-high-capacity-4s-10000mah-multi-rotor-lipo-pack.html>`__
|                     UBEC ZTW 6A                           12g          2     `Banggood <http://www.banggood.com/ZTW-10A-BEC-UBEC-Universal-Battery-Eliminator-Circuit-For-RC-Models-p-989402.html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>`__
**Power Loom**        XT60 Connectors (5 pairs)                          1     `Banggood <http://www.banggood.com/5X-XT60-Male-Female-Bullet-Connectors-Plugs-For-RC-Battery-p-916559.html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>`__
|                     XT30 Connectors (10 Pairs)                         1     `Banggood <http://www.banggood.com/10X-Amass-XT30-UPB-2mm-Plug-Male-Female-Bullet-Connectors-Plugs-For-PCB-p-1063274.html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>`__
|                     Cable 12AWG 330mm 1xBlack + 1xRed                  1     `Black <https://hobbyking.com/en_us/turnigy-high-quality-12awg-silicone-wire-1m-black.html>`_ `Red <https://hobbyking.com/en_us/turnigy-high-quality-12awg-silicone-wire-1m-red.html>`_
|                     Cable 14AWG 530mm 1xBlack + 1xRed                  1     `Black <https://hobbyking.com/en_us/turnigy-high-quality-14awg-silicone-wire-1m-black.html>`_ `Red <https://hobbyking.com/en_us/turnigy-high-quality-14awg-silicone-wire-1m-red.html>`_
|                     Cable 18AWG 160mm 1xBlack + 1xRed                  1     `Black <https://hobbyking.com/en_us/turnigy-high-quality-18awg-silicone-wire-1m-black.html>`_ `Red <https://hobbyking.com/en_us/turnigy-high-quality-18awg-silicone-wire-1m-red.html>`_
|                     Cable 20AWG 360mm 1xBlack + 1xRed                  1     `Black <https://hobbyking.com/en_us/turnigy-high-quality-20awg-silicone-wire-1m-black.html>`_ `Red <https://hobbyking.com/en_us/turnigy-high-quality-20awg-silicone-wire-1m-red.html>`_
**Avionics**          Pixhawk                                39g         1     `Banggood <http://www.banggood.com/Pixhawk-PX4-2_4_8-Flight-Controller-32-Bit-ARM-PX4FMU-PX4IO-Combo-for-Multicopters-p-1040416.html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>`__
|                     GPS Neo-M8N                            18g         1     `Banggood <http://www.banggood.com/Ublox-NEO-M8N-Flight-Controller-GPS-with-Protective-Shell-for-PIX-PX4-Pixhawk-p-1005394.html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>`__
|                     Digital Airspeed with Pitot             3g         1     `HobbyKing <https://hobbyking.com/en_us/hkpilot-32-digital-air-speed-sensor-and-pitot-tube-set.html>`__
|                     I2C Hub                                 4g         1     `Banggood <http://www.banggood.com/CRIUS-Pixhawk-I2C-Splitter-Expand-Module-For-Pix-APM-Flight-Controller-p-984147.html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>`__
|                     Power Module and Sensor                22g         1     `HobbyKing <https://hobbyking.com/en_us/hkpilot-mega-10s-power-module-with-xt60-connectors.html>`__
|                     Servo ext. cables 15cm                             1     `HobbyKing <https://hobbyking.com/en_us/15cm-servo-lead-extention-jr-with-hook-26awg-5pcs-bag.html>`_
|                     Servo ext. cables 30cm                             1     `HobbyKing <https://hobbyking.com/en_us/30cm-servo-lead-extention-jr-with-hook-26awg-5pcs-bag.html>`_
|                     Screws                                                   Countersunk Screws M3 4x10mm, 4x18mm. M2.5 4x12mm
|                     Damping Balls                                      4     `HobbyKing <https://hobbyking.com/en_us/vibration-damping-ball-50gram-8-pcs-bag.html>`_
**Comms & RC**        RFD900x (1 Air & 1 Ground req) **      12g         2     `RFD Aus <http://store.rfdesign.com.au/rfd-900x-modem/>`__
|                     Pixhawk to RFD900x Cable                2g         1     `RFD Aus <http://store.rfdesign.com.au/pixhawk-to-rfd900-telemetry-cable-300mm/>`_
|                     USB to FTDI Cable                      50g         1     `RFD Aus <http://store.rfdesign.com.au/ftdi-cable-3-3v/>`_
|                     Antenna 900MHz 3dBi Dipole (RPSMA)     21g         2     `RFD Aus <http://store.rfdesign.com.au/antenna-900mhz-3dbi-dipole-rpsma/>`_
|                     Foil Antenna 300mm (or 500mm)           7g         2     `RFD Aus <http://store.rfdesign.com.au/rfdflex1-900mhz-flexible-pcb-antenna-300mm-rpsma/>`__
|                     FrSKy XSR                               4g         1     `Banggood <http://www.banggood.com/FrSky-XSR-2_4GHz-16CH-ACCST-Receiver-S-Bus-CPPM-Output-Support-X9D-X9E-X9DP-X12S-X-Series-p-1031481.html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>`__
**Servos**            Corona DS-929MG                        12g ea.     5     `HobbyKing <https://hobbyking.com/en_us/corona-digital-servo-2-2kg-0-11sec-12-5g.html>`__
**Companion Pi**      Raspberry Pi Zero W                    10g         1     `PiHut <https://thepihut.com/products/raspberry-pi-zero-w>`__
|                     Pi Camera v2                            3g         1     `PiHut <https://thepihut.com/collections/raspberry-pi-camera/products/raspberry-pi-camera-module>`__
|                     Pi Camera to Zero Cable                 1g         1     `PiHut <https://thepihut.com/collections/raspberry-pi-camera/products/raspberry-pi-zero-camera-adapter>`__
|                     Powered USB Zero4U Hub                 14g         1     `PiHut <https://thepihut.com/products/adafruit-zero4u-4-port-usb-hub-for-raspberry-pi-zero-v1-3>`__
|                     Pi Reboot Relay (pololu RC small)       1g         1     `LittleBird Aus <https://littlebirdelectronics.com.au/products/pololu-rc-switch-with-small-low-side-mosfet>`__
|                     SD Card 8GB (or Larger)                 1g         1
====================  =================================== ========== ======== ======================================

.. Note::
   All RF equipment, antennas and radios should be thoroughly range tested on each aircraft and base station setup. Please see the respective build sections prior to purchasing for more details.

3D Printed Parts
^^^^^^^^^^^^^^^^

3D Printed parts can be printed using a selection of materials, we made our aircraft parts from PLA as this was the easiest and was rigid enough.
Using ABS, especially on the larger Avionics Enclosure parts might be difficult. Some parts are printed on the side as noted.
Not every 3D printer is configured the same so some might not print at the correct size to fit the individual electronic components etc, if so, try using the scale feature on the slicer to increase or decrease the size as required.
Note that all the prints that connect to each other will require the same scale so they fit together properly once assembled.

.. Tip::
  When 3D printing ABS and some other filaments, it is good practice to do so in a well ventilated area and not inhale the fumes directly as they are toxic.

3D Printed Parts List
^^^^^^^^^^^^^^^^^^^^^

Please either select the individual STL 3D print files individually from the list below or clone the github `repo <https://github.com/sarsky/Mozzie/tree/master/3d>`_.

.. Tip::
  Clicking the 3D part link will open the part in Github where you can use the download button in the top left of the viewer.

Airframe Parts
^^^^^^^^^^^^^^^^

| `Talon Box Bridge (Vial holder) <https://github.com/sarsky/Mozzie/blob/master/3d/Airframe/Talon%20Box%20Cross%20Section.stl>`_
| `Talon Box Left Side <https://github.com/sarsky/Mozzie/blob/master/3d/Airframe/Talon%20Box%20Wall%20L%20(Vial%20near%20CF).stl>`_
| `Talon Box Right Side <https://github.com/sarsky/Mozzie/blob/master/3d/Airframe/Talon%20Box%20Wall%20R%20(Vial%20near%20CF).stl>`_
| `Front Skid <https://github.com/sarsky/Mozzie/blob/master/3d/Airframe/Front%20Skid.stl>`_
| `Tail Skid <https://github.com/sarsky/Mozzie/blob/master/3d/Airframe/Tail%20skid.stl>`_
| `Forward Motor Mount <https://github.com/sarsky/Mozzie/blob/master/3d/Airframe/Mount%20Motor%20v1.stl>`_
|

**Optional:**
| `GPS M8 Mount <https://github.com/sarsky/Mozzie/blob/master/3d/Airframe/Gps%20Mount%20M8.stl>`_
| `GPS Cable Conduit Long <https://github.com/sarsky/Mozzie/blob/master/3d/Airframe/Long%20GPS%20Cable%20Conduit%2080mm.stl>`_
| `GPS Cable Conduit Short <https://github.com/sarsky/Mozzie/blob/master/3d/Airframe/Short%20GPS%20Cable%20Conduit%2036mm.stl>`_
| `E-Stop Holder <https://github.com/sarsky/Mozzie/blob/master/3d/Airframe/E-Stop.stl>`_
| `ESC Air Scoop <https://github.com/sarsky/Mozzie/blob/master/3d/Airframe/ESC%20Scoop.stl>`_
|

Avionics Parts
^^^^^^^^^^^^^^^^

| `Avionics Enclosure Pi (bottom) <https://github.com/sarsky/Mozzie/blob/master/3d/Avionics/AE%20Pi.stl>`_
| `Avionics Enclosure RFD/Air (top) <https://github.com/sarsky/Mozzie/blob/master/3d/Avionics/AE%20Top%20Box.stl>`_
| `Avionics Enclosure Plate (center) <https://github.com/sarsky/Mozzie/blob/master/3d/Avionics/AE%20Plate.stl>`_
| `Avionics Enclosure Front Mount <https://github.com/sarsky/Mozzie/blob/master/3d/Avionics/AE%20Front%20Mount.stl>`_
| `Avionics Enclosure Rear Mount <https://github.com/sarsky/Mozzie/blob/master/3d/Avionics/AE%20Rear%20Mount.stl>`_
| `Avionics Enclosure Screw Washers <https://github.com/sarsky/Mozzie/blob/master/3d/Avionics/Screw%20washer.stl>`_
| `AE Camera Servo Mount PiCam <https://github.com/sarsky/Mozzie/blob/master/3d/Avionics/AE%20Camera%20Servo%20Mount.stl>`_
| `Camera PiCam Holder <https://github.com/sarsky/Mozzie/blob/master/3d/Avionics/AE%20Camera%20Case.stl>`_
|

**Optional:**
| `Airspeed Sensor Mount (v4.1) <http://www.thingiverse.com/thing:169317>`_
| `Arm Switch Mount <https://github.com/sarsky/Mozzie/blob/master/3d/Avionics/Arm%20Switch.stl>`_
| `3G Modem E3351 <https://github.com/sarsky/Mozzie/blob/master/3d/Avionics/3G%20Modem.stl>`_
|

Quad Arm Parts
^^^^^^^^^^^^^^^^

| `CF Motor Mount Left <https://github.com/sarsky/Mozzie/blob/master/3d/QuadArm/CF%20Motor%20Mount%20LEFT%20Aero%20v4.stl>`_
| `CF Motor Mount Right <https://github.com/sarsky/Mozzie/blob/master/3d/QuadArm/CF%20Motor%20Mount%20Right%20Aero%20v4.stl>`_
| `CF Middle Left <https://github.com/sarsky/Mozzie/blob/master/3d/QuadArm/CF%20Mid%20Mount%20L.stl>`_
| `CF Middle Right <https://github.com/sarsky/Mozzie/blob/master/3d/QuadArm/CF%20Mid%20Mount%20R.stl>`_
| `Undermount 2x <https://github.com/sarsky/Mozzie/blob/master/3d/QuadArm/Undermount%20back%20V7.stl>`_
|

Workspace
---------

For the construction of the Mozzie you will need a large well lit table about 1.5m wide and a power plug for soldering iron, hot glue and the optional heat gun.

Tools Required
--------------

The most expensive tools required to build the Mozzie are a good soldering iron and a hot glue gun.
A hot air gun is optional to heatshrink the components like the quad arms, but it is recommended for a good finish.
A third hand to hold onto parts whilst soldering is also recommended.

Hand tool required:
 1) Hobby knife with replacement blades
 2) A good pair of sharp scissors
 3) A Philips and hex screw driver with the following sizes

Consumables Required:
 1) UHU Por (this glue is ideal for foam because it stays flexible and has a strong bond)
 2) A good quality clear packaging tape and a mesh reinforced tape
 3) 180 grit Sandpaper

Recommended
 1) Soldering iron holder
 2) Hot Air Gun
 3) Cutting mat

Safety
------

The two most dangerous things in building a Mozzie are cuts and burns.

Hobby knives and scissors are very sharp and should be handled with care, try not to use too much force when cutting and cut away from yourself.

The soldering iron and heat gun can cause serious burns that may require treatment by a doctor or hospital.
Use care to place the hot items on a non-flammable materials, out of the way so they can't be touched or bumped into. A soldering iron holder is recommended.

.. Caution::
  Soldering also produces toxic fumes so ensure that a well ventilated room and/or small extraction fan is used.
  They can also present a fire danger so keep them away from flammable items and make sure they are turned off when you leave them.

Remember making the Mozzie should be fun, but getting hurt is not!
