sarsky/Mozzie/docs/source/SoftwareSetup.rst

Software and Firmware
=====================

Comms
------------

  Add Comms setup info like IP and Channels etc

.. Warning::
  Before doing any of the following tests, remove all the propellers from the aircraft.
  Failure to do so can lead to serious injury that can require hospitalization. All propellers are dangerous, sharp and can easily cut to the bone if not handled carefully. Use Caution. Remove Props!

Pixhawk
...............

Installing latest Arduplane on PXH link
Writing Parameters to PXH using MP link 
AHRS Orientation, MP RC calibration, ACC Cal, Mag Cal/orientation, Bat Mon setup and V+A cal

Comms Setup
-----------

 Add Comms setup info like IP and Channels etc

Failsafe Setup
.................
