sarsky/Mozzie/docs/source/PiSetup.rst

Raspberry Pi Zero W Setup
===========================
 
Make the USB hub optional as the pi Zero W has wifi now
How to connect to PXH and power
How to write download and write image to SD Card link
