sarsky/Mozzie/docs/source/images/Fuselage/TalonBoxAssembled.jpg

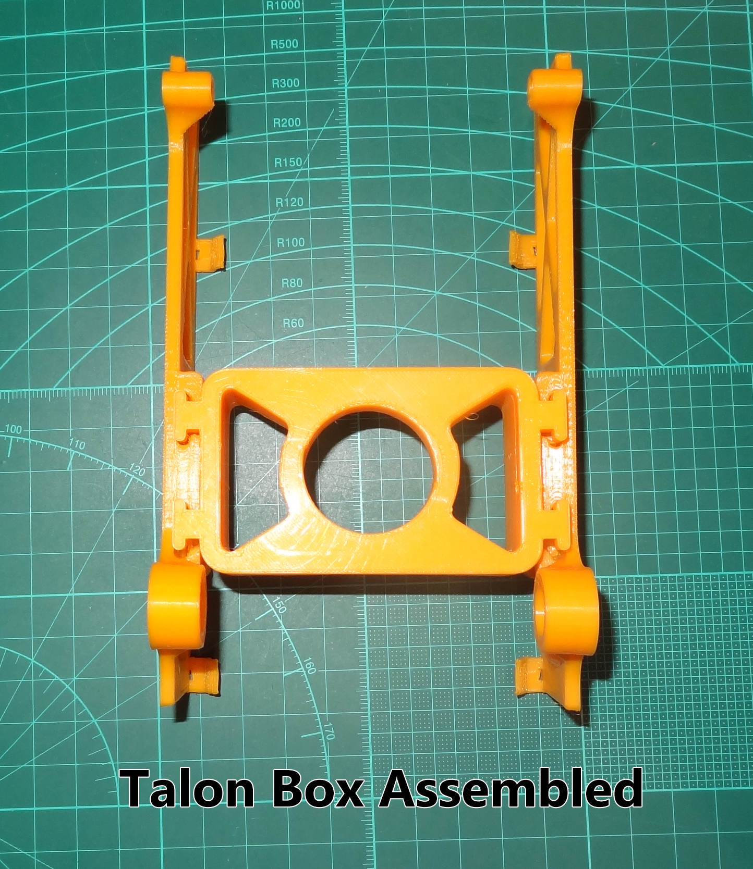
docs/source/images/Fuselage/TalonBoxAssembled.jpg
