sarsky/Mozzie/3d/BLHeli_OBC Mozzie FWD - ZTWSpPro20AHV - Rev. 14.3 - Multi_170701.ini

[ESC0]
Eep_Name=OBC ZTW Fwd
Eep_ESC_Layout=ZTWSpPro20AHV
Eep_ESC_MCU=#BLHELI#F390#
Eep_ESC_Mode=2
Eep_FW_Main_Revision=14
Eep_FW_Sub_Revision=3
Eep_Layout_Revision=20
Eep_Pgm_Gov_P_Gain=9
Eep_Pgm_Gov_I_Gain=9
Eep_Pgm_Gov_Mode=4
Eep_Pgm_Motor_Gain=3
Eep_Pgm_Startup_Pwr=9
Eep_Pgm_Pwm_Freq=2
Eep_Pgm_Direction=2
Eep_Pgm_Input_Pol=1
Eep_Enable_TX_Setup=0
Eep_Pgm_Comm_Timing=3
Eep_Pgm_Ppm_Min_Throttle=0
Eep_Pgm_Ppm_Max_Throttle=250
Eep_Pgm_Beep_Strength=40
Eep_Pgm_Beacon_Strength=80
Eep_Pgm_Beacon_Delay=5
Eep_Pgm_Demag_Comp=2
Eep_Pgm_BEC_Voltage_High=0
Eep_Pgm_Ppm_Center_Throttle=125
Eep_Pgm_Temp_Prot_Enable=0
Eep_Pgm_Enable_Power_Prot=1
Eep_Pgm_Enable_Pwm_Input=1
Eep_Pgm_Pwm_Dither=3
