sarsky/Mozzie/(commit log)

2017-05-26 RFD900 ground power setup
2017-05-27 Add .stl part files
    [3G Modem.stl, AE Camera Servo Mount.stl, AE Front Mount.stl, AE Pi.stl, AE Plate.stl, AE RFD%2FAir.stl, AE Rear Mount.stl, Arm Switch.stl]
2017-06-14 Updated part orientation for 3D printing.
    [ESC Scoop.stl, Long GPS Cable Conduit 80mm.stl, Tail skid.stl, Talon Box Cross Section.stl, Talon Box Wall L (Vial near CF).stl]
2017-06-16 Added avionics intro
    [Screw Washer.stl]
2017-07-01 Updaes text ESC/AE
2017-07-05 Edit Note Formating
    [Screw washer.stl]
2017-07-07 Fuselage Images
2017-07-07 Wing Images
2017-07-08 ACC/RFD/ESC edits
2017-07-11 Txt Edit LED
2017-07-11 TXT edit LEDv2
2017-07-14 Update PowerLoom.rst
    DB S_CHK
2017-07-15 Github Part Links
    [AE Camera Case.stl, Ball Mount Screw Washer Large.stl, Ball Mount Screw Washer Small.stl, Gps Mount M8.stl, Pitot Tube Front 4-1mm.stl, Pitot Tube base.stl, Short GPS Cable Conduit 36mm.stl]
2017-07-15 Update STL Link
2017-07-24 Props Update
2017-07-29 CM3 stl
